CharelF01/CREPO3/Photos/IMG_20230130_124924.jpg

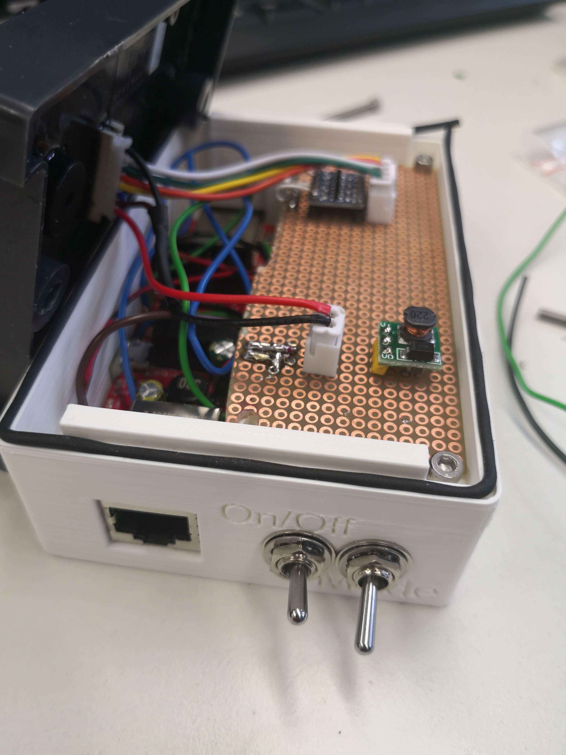
Photos/IMG_20230130_124924.jpg
