CharelF01/CREPO3/README.md

# CREPO3
This project was done in the scope of the BTS-Internet of Things in the Lycée des Arts et Métiers Luxembourg.
The Creative Project 3's objective was to create an RFID reader for a charity run which sends an API request to handle input data from runners.

Mark received on Project: 15.7/20
