CharelF01/CREPO3/Photos/image1.png

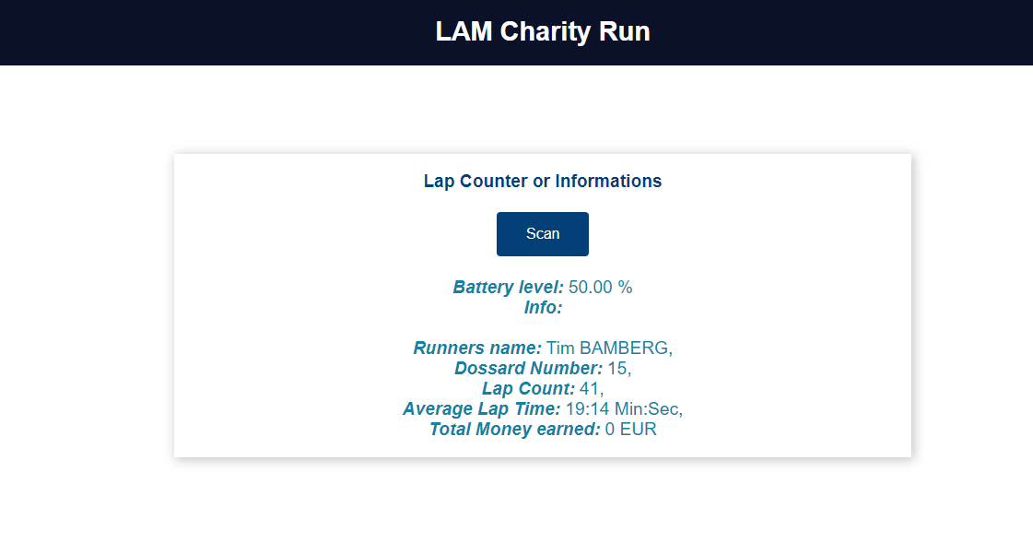
Photos/image1.png
