CharelF01/CREPO3/Photos/image2.png

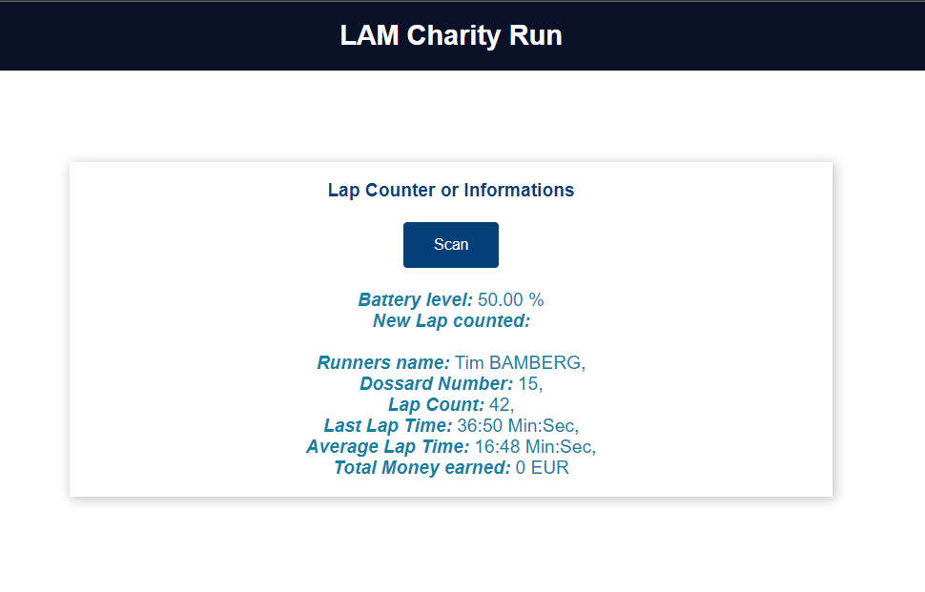
Photos/image2.png
