CharelF01/CREPO3/Photos/image3.png

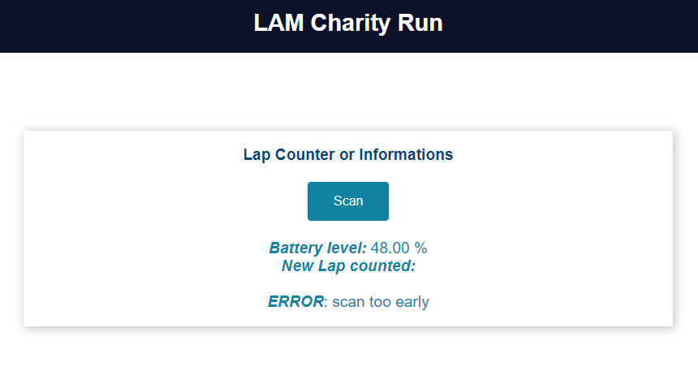
Photos/image3.png
