CharelF01/CREPO3/Photos/IMG_20230130_124701.jpg

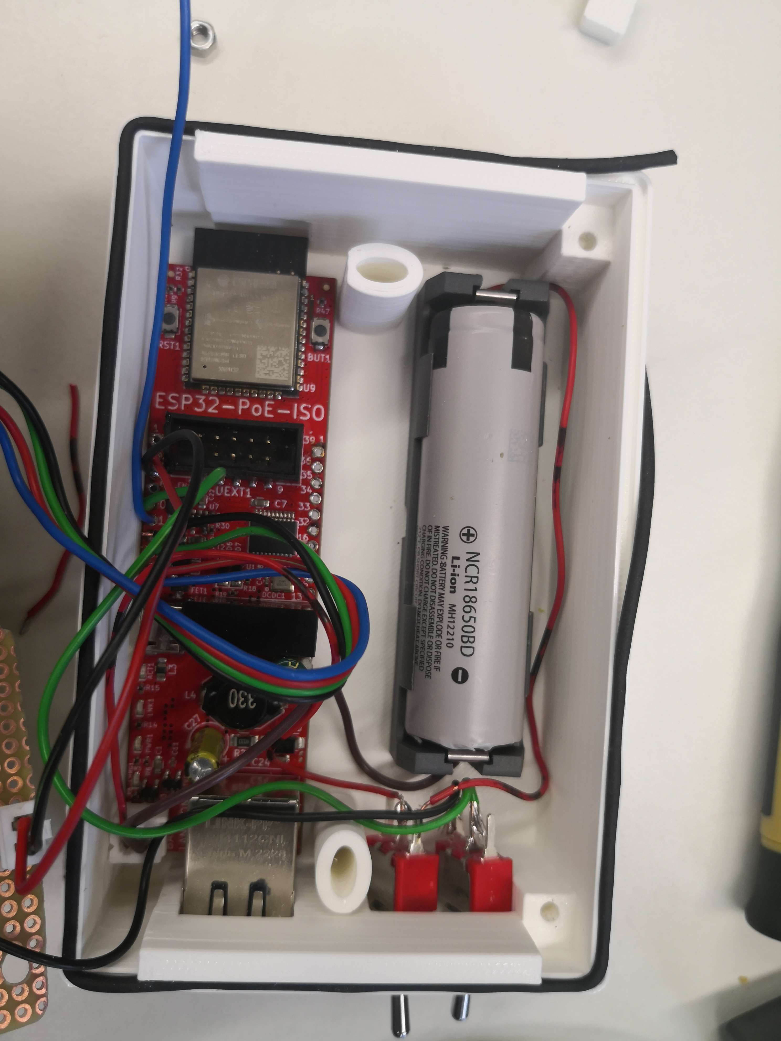
Photos/IMG_20230130_124701.jpg
