CharelF01/CREPO3/Photos/IMG_20230130_213450.jpg

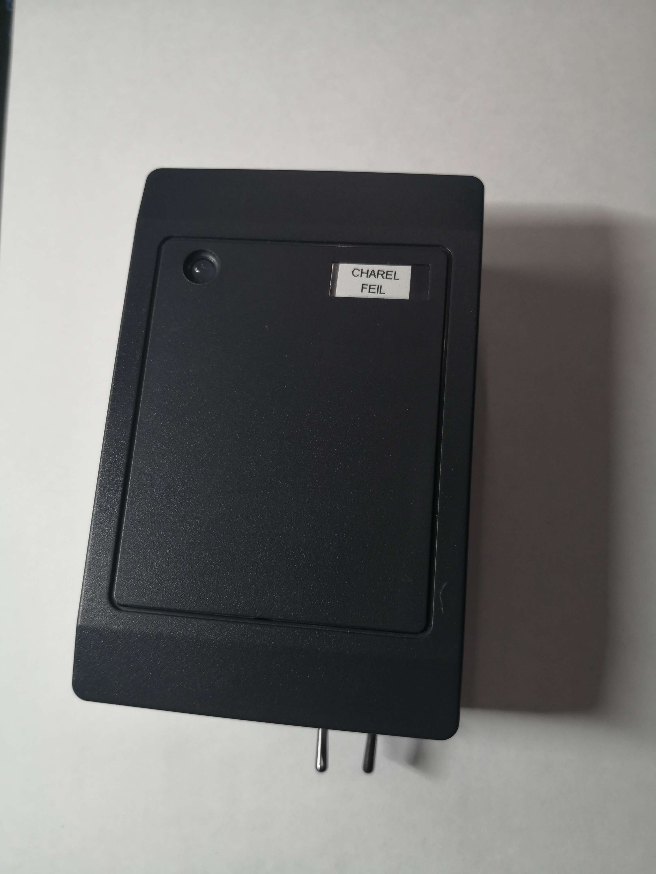
Photos/IMG_20230130_213450.jpg
