CharelF01/CREPO3/Photos/Screenshot_20230130_140644_com.android.chrome.jpg

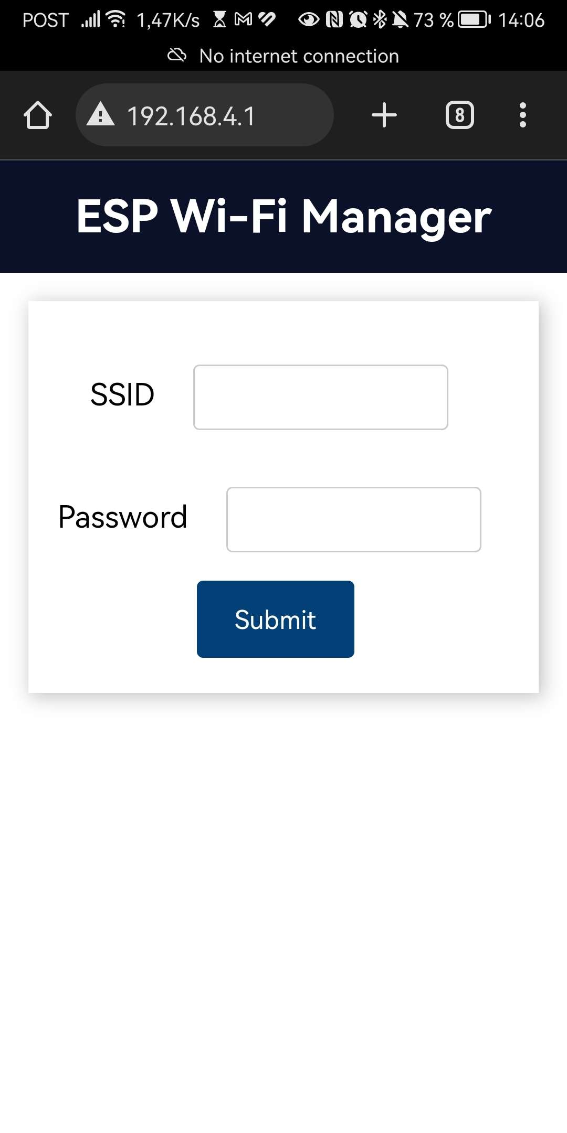
Photos/Screenshot_20230130_140644_com.android.chrome.jpg
