CharelF01/CREPO3/Photos/Screenshot_20230130_140652_com.android.chrome.jpg

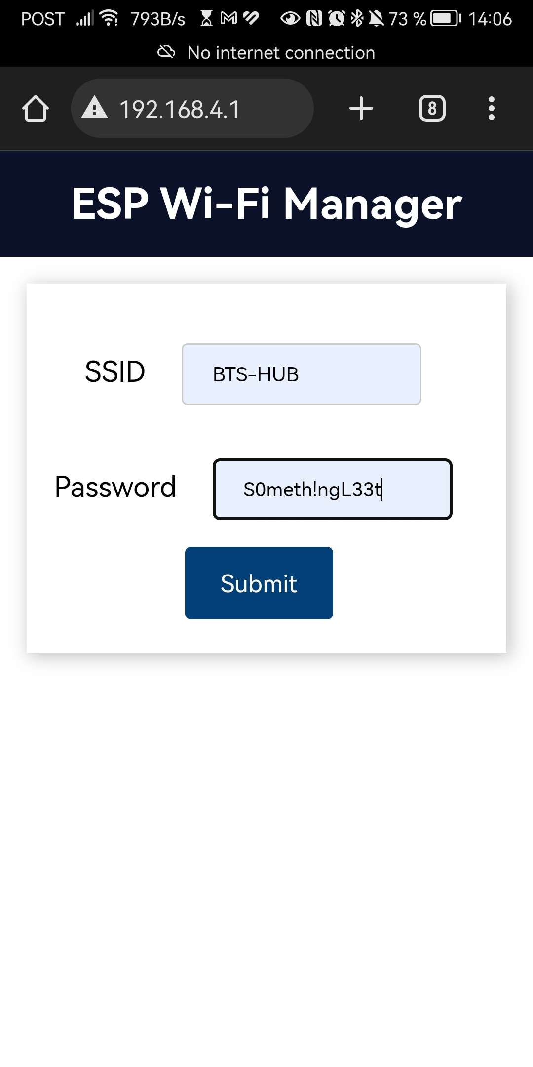
Photos/Screenshot_20230130_140652_com.android.chrome.jpg
