CharelF01/CREPO3/Documents/CREPO-3-Manual.pdf

## CREPO 3 Manual

To make the RFID scanner operational, you need to flip the ON/OFF switch to the DOWN position, the indication that the device is ON is the light on the front glowing red.

If the device is already connected to the ETHERNET port, you’re good to go. The scanner should be operational.

If the device should be connected via WIFI and it hasn’t yet been connected to the appropriate network, you need to take a WIFI compatible smartphone, laptop or other device and connect to the WIFI called “Charity Run WIFI Config” and navigate to this site:

http://192.168.4.1/

There you will be asked to enter the network SSID (Name) and password. When you press the submit button, the device will connect automatically to the selected network.

Then the device is now operational. The scanned data can be viewed from the IP address of the device. This is shown after the network selector screen.

The only thing to note is that to count laps you need to put the MODE switch into the DOWN position. The UP position is only to get information.

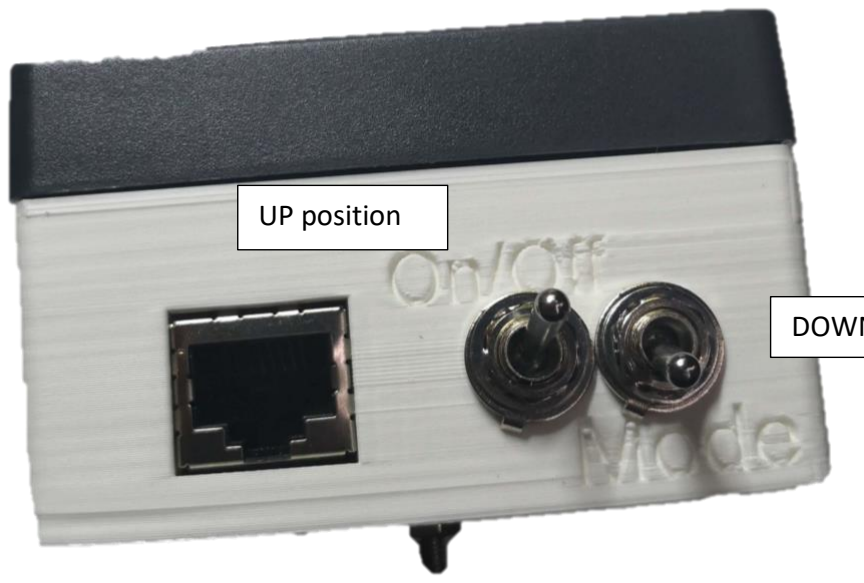
[picture p29: figure]
UP position

DOWN position
