CharelF01/CREPO3/(list of files, drawings)

Other design files:
Circuit/CREPO3CirCuit.fzz
